viam-labs/hawkeye/3d/right-arm.stl

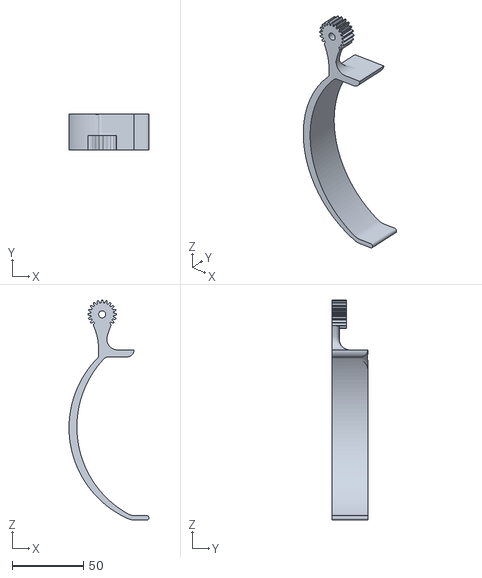
[picture p4: CAD file, 2026-09-03]
3d/right-arm.stl
56.3 x 25.0 x 154.8
