viam-labs/hawkeye/3d/camera-bracket.stl

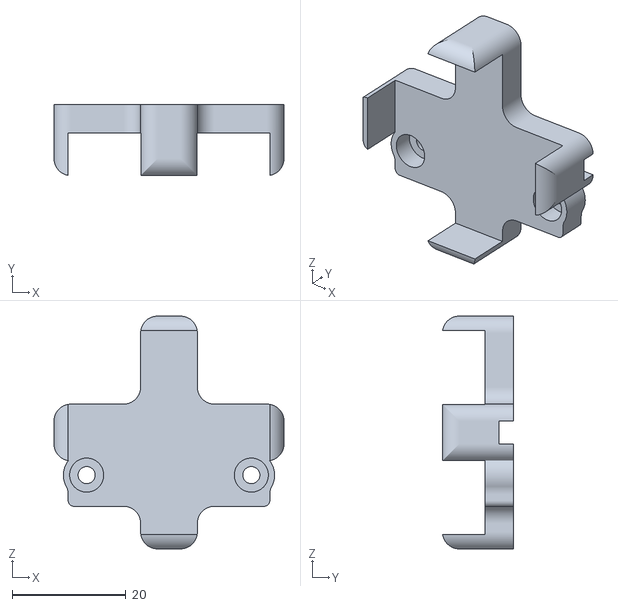
[picture p5: CAD file, 2026-09-03]
3d/camera-bracket.stl
40.5 x 12.5 x 41.0
