viam-labs/hawkeye/3d/left-arm.stl

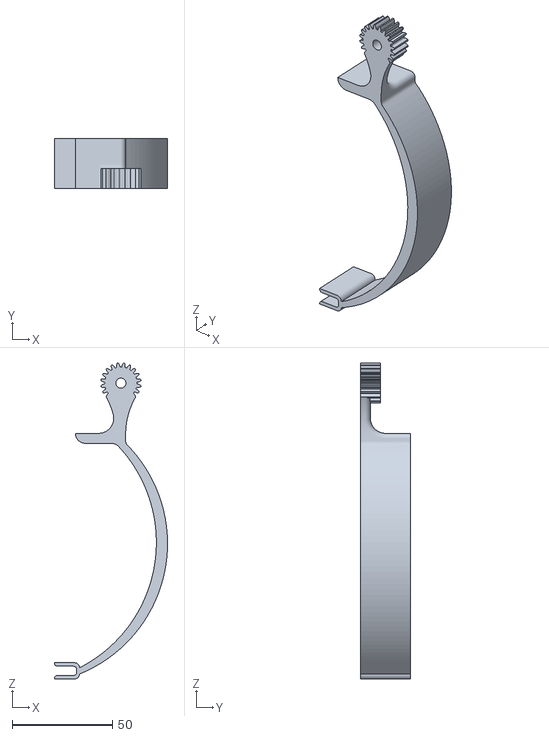
[picture p6: CAD file, 2026-09-03]
3d/left-arm.stl
56.3 x 25.0 x 157.2
