viam-labs/hawkeye/3d/plate.stl

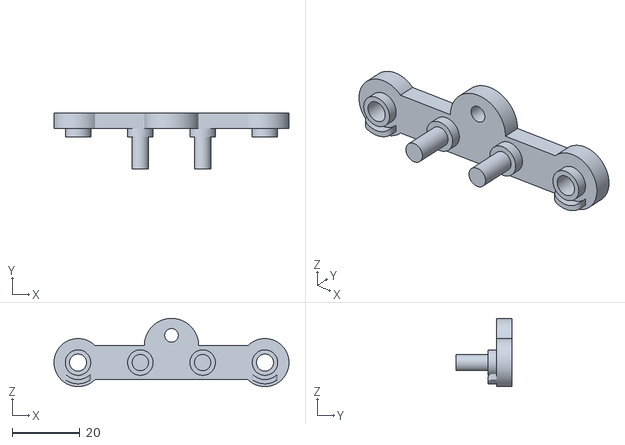
[picture p7: CAD file, 2026-09-03]
3d/plate.stl
69.1 x 16.5 x 20.1
