viam-labs/hawkeye/3d/camera-brace.stl

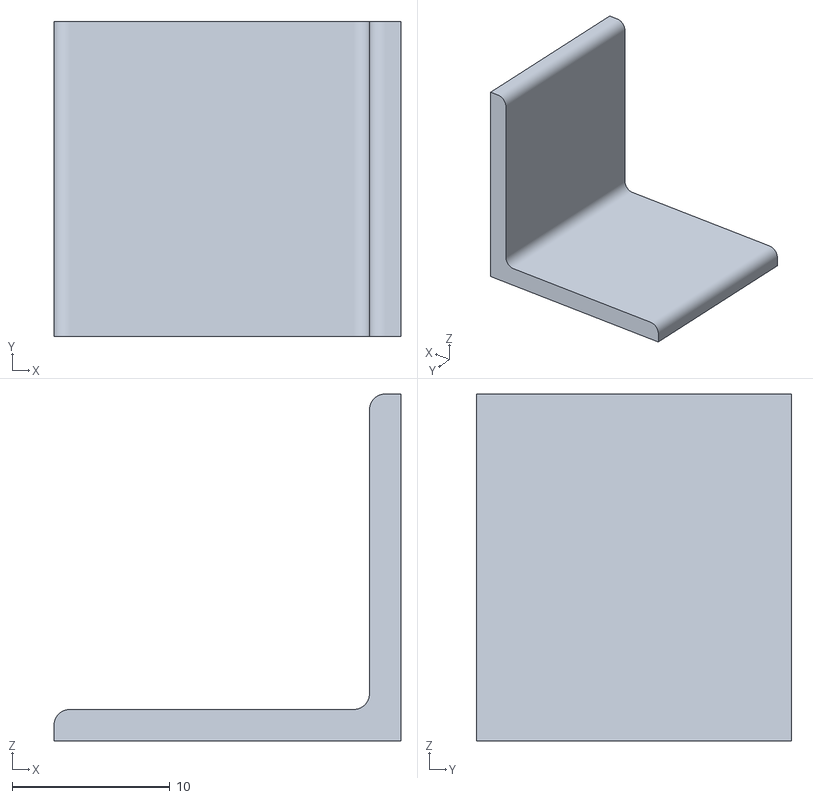
[picture p8: CAD file, 2026-09-03]
3d/camera-brace.stl
22.0 x 20.0 x 22.0
