viam-labs/hawkeye/3d/servo-bracket.stl

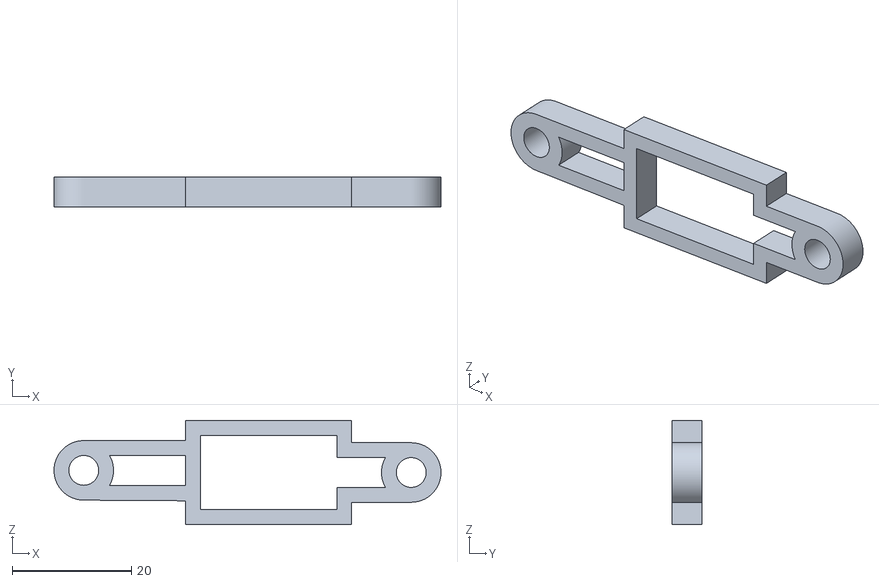
[picture p9: CAD file, 2026-09-03]
3d/servo-bracket.stl
65.0 x 5.00 x 17.5
