viam-labs/hawkeye/3d/driver-gear.stl

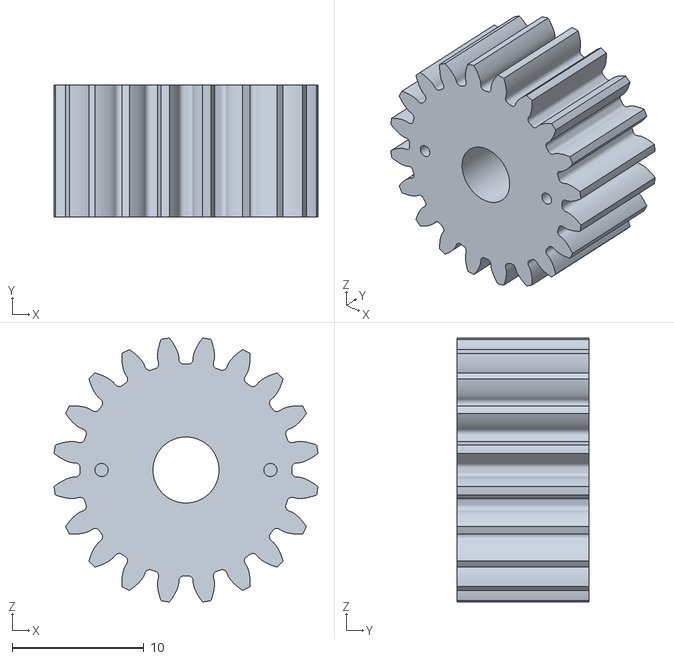
[picture p10: CAD file, 2026-09-03]
3d/driver-gear.stl
20.0 x 10.0 x 20.0
