viam-labs/hawkeye/(list of files, cad)

Other CAD files:
3d/idler-gear.stl
